Grant-E-G/muon_telescope/docs/datasheets/README.md

# Datasheet archive

This directory is the local design-document archive for selected parts and
existing equipment. Files were retrieved 2026-08-23 unless a later date is
stated, and are kept unmodified. The pulse-height documents were retrieved
2026-09-01.
Use the exact manufacturer number below: a family document does not make every
family member interchangeable. Recheck the linked primary source and revision
before a fabrication release because the local copy is intentionally a
snapshot.

When a part changes, update its BOM entry, local document, and this index in the
same change. Prefer manufacturer documents. Distributor pages are ordering
references, not substitutes for electrical or mechanical documentation.

## Semiconductors and power

| Selected manufacturer part(s) | Local document | Primary source |
|---|---|---|
| onsemi `MICROFC-60035-SMT-TR` | [C-Series datasheet](onsemi-microc-series.pdf); [bias/readout note AND9782/D](onsemi-and9782-sipm-bias-readout.pdf) | [onsemi datasheet](https://www.onsemi.com/pdf/datasheet/microc-series-d.pdf); [onsemi application note](https://www.onsemi.com/download/application-notes/pdf/and9782-d.pdf) |
| 3PEAK `TPH2502-SR` | [TPH2501-TPH2504 datasheet](3peak-tph2501-tph2504.pdf) | [3PEAK](https://static.3peak.com/res/doc/ds/Datasheet_TPH2501-TPH2502-TPH2503-TPH2504.pdf) |
| TI `TLV3502AIDR` | [TLV3501/TLV3502 datasheet](ti-tlv3501-tlv3502.pdf) | [TI](https://www.ti.com/lit/gpn/TLV3502) |
| TI `SN74LVC1G123DCTR` | [SN74LVC1G123 datasheet](ti-sn74lvc1g123.pdf) | [TI](https://www.ti.com/lit/ds/symlink/sn74lvc1g123.pdf) |
| Microchip `MCP3202-BI/SN` | [MCP3202 datasheet](microchip-mcp3202.pdf) | [Microchip](https://ww1.microchip.com/downloads/en/DeviceDoc/21034F.pdf) |
| Nexperia `BAS70,215` | [BAS70 datasheet](nexperia-bas70.pdf) | [Nexperia](https://assets.nexperia.com/documents/data-sheet/BAS70.pdf) |
| Nexperia `BSS138P,215` | [BSS138P datasheet](nexperia-bss138p.pdf) | [Nexperia](https://assets.nexperia.com/documents/data-sheet/BSS138P.pdf) |
| TI `TMUX1101DCKR` (precision reset alternate) | [TMUX1101/TMUX1102 datasheet](ti-tmux1101.pdf) | [TI](https://www.ti.com/lit/ds/symlink/tmux1101.pdf) |
| ADI/Maxim `MAX5026EUT+T` | [MAX5025-MAX5028 datasheet](adi-max5025-max5028.pdf) | [Analog Devices](https://www.analog.com/media/en/technical-documentation/data-sheets/max5025-max5028.pdf) |
| TI `TLV75533PDBVR` | [TLV755P datasheet](ti-tlv755p.pdf) | [TI](https://www.ti.com/lit/gpn/TLV755P) |
| onsemi `SS16HE` | [SS13HE-SS16HE datasheet](onsemi-ss13he-ss16he.pdf) | [onsemi](https://www.onsemi.com/pdf/datasheet/ss13he-d.pdf) |
| onsemi `SS14` | [SS12-SS110 datasheet](onsemi-ss12-ss110.pdf) | [onsemi](https://www.onsemi.com/pdf/datasheet/ss19-d.pdf) |
| Diodes Inc. `BAT54S-7-F` | [BAT54-series datasheet](diodes-bat54-series.pdf) | [Diodes Inc.](https://www.diodes.com/datasheet/download/BAT54S.pdf) |

## Passives

| Selected manufacturer part(s) | Local document | Primary source |
|---|---|---|
| Bourns `SRN6045-470M` | [SRN6045 datasheet](bourns-srn6045.pdf) | [Bourns](https://www.bourns.com/docs/product-datasheets/srn6045.pdf) |
| Littelfuse `1206L050YR` | [1206L datasheet](littelfuse-1206l.pdf) | [Littelfuse](https://www.littelfuse.com/assetdocs/littelfuse-ptc-1206l-datasheet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) |
| Bourns `3296W-1-501LF`, `3296W-1-103LF` | [3296 trimmer datasheet](bourns-3296.pdf) | [Bourns](https://www.bourns.com/pdfs/3296.pdf) |
| Panasonic `ERA-6AEB1473V`, `ERA-6AEB6981V` | [ERA-A resistor datasheet](panasonic-era-a-resistors.pdf) | [Panasonic](https://industrial.panasonic.com/cdbs/www-data/pdf/RDM0000/AOA0000C307.pdf) |
| Yageo `RC0805JR-070RL`, `RC0805FR-0710RL`, `RC0805FR-0722RL`, `RC0805FR-0749R9L`, `RC0805FR-0756RL`, `RC0805FR-0782RL`, `RC0805FR-07100RL`, `RC0805FR-07220RL`, `RC0805FR-07499RL`, `RC0805FR-071KL`, `RC0805FR-071K65L`, `RC0805FR-072KL`, `RC0805FR-074K7L`, `RC0805FR-0710KL`, `RC0805FR-0712K4L`, `RC0805FR-07100KL`, `RC0805FR-07130KL`, `RC0805FR-07330KL`, `RC0805FR-071ML` | [RC_L resistor datasheet](yageo-rc-l-resistors.pdf) | [Yageo](https://yageogroup.com/content/datasheet/asset/file/PYU-RC_GROUP_51_ROHS_L) |
| KEMET `C0805C104K5RACTU`, `C0805C105K4RACTU`, `C0805C475K4RACTU`, `C1206C106K8RACTU`, `C1206C105K5RACTU` | [X7R MLCC datasheet](kemet-x7r-mlcc.pdf) | [Yageo/KEMET](https://yageogroup.com/content/datasheet/asset/file/KEM_C1002_X7R_SMD) |
| KEMET `C0805C103J1GACTU`, `C0805C270J5GACTU`, `C0805C101J5GACTU`, `C0805C221J5GACTU`, `C0805C471J5GACTU`, `C0805C102J5GACTU`, `C0805C229C5GACTU` | [C0G MLCC datasheet](kemet-c0g-mlcc.pdf) | [Yageo/KEMET](https://yageogroup.com/content/datasheet/asset/file/KEM_C1003_C0G_SMD) |

## Connectors, cables, and external power

| Selected manufacturer part(s) | Local document | Primary source |
|---|---|---|
| JST `B10B-XH-A(LF)(SN)`, `XHP-10` | [XH connector datasheet](jst-xh-connectors.pdf) | [JST](https://www.jst-mfg.com/product/pdf/eng/eXH.pdf) |
| JST `ASXHSXH22K305` | [assembly drawing](jst-asxhsxh22k305-drawing.pdf) | [assembly drawing](https://gam-gec.com/wp-content/uploads/2018/10/GAM-198.pdf); [JST ordering page](https://www.digikey.com/en/products/detail/jst-sales-america-inc/ASXHSXH22K305/6684932) |
| Same Sky `PJ-102AH` | [connector datasheet](same-sky-pj-102ah.pdf) | [Same Sky](https://www.cuidevices.com/product/resource/pj-102ah.pdf) |
| Phihong `PSAC05A-050L6-R` | [PSAC05A datasheet](phihong-psac05a.pdf) | [Phihong](https://www.phihong.com/wp-content/uploads/PSAC05A.pdf) |
| Samtec `TSW-106-08-G-D-RA`, `TSW-120-07-G-S` | [TSW drawing](samtec-tsw-header-drawing.pdf) | [Samtec](https://suddendocs.samtec.com/prints/tsw-xxx-xx-xxx-x-xx-xxx-mkt.pdf) |
| Samtec `SNT-100-BK-G` | [SNT drawing](samtec-snt-shunt-drawing.pdf) | [Samtec](https://suddendocs.samtec.com/prints/snt-100-xx-x-x-mkt.pdf) |
| Digilent `240-109` | [Pmod interface specification](digilent-pmod-interface-specification-1.3.0.pdf) | [Digilent cable page](https://digilent.com/shop/2x6-pin-pmod-cable/); [Digilent specification](https://digilent.com/reference/_media/reference/pmod/pmod-interface-specification-1_3_0.pdf) |

Digilent does not publish a separate cable drawing for `240-109`; its product
page and the archived Pmod interface specification are the available primary
documentation. Continuity and mating orientation therefore remain an incoming
inspection requirement.

## Optical parts and existing equipment

| Selected item | Local document | Primary source |
|---|---|---|
| Bicron/Luxium BC-408; purchased seller-cut model `BC408-505010-1FP`, 50 x 50 x 10 mm, one face polished | [BC-400/404/408/412/416 datasheet](luxium-bc400-bc416.pdf) | [Luxium](https://luxiumsolutions.com/files/1691/download); [purchased cut-geometry listing](https://www.ebay.com/itm/254751779655) (no manufacturer drawing exists for the seller-cut geometry) |
| Eljen `EJ-550` optical coupling compound | [EJ-550/EJ-552 datasheet](eljen-ej550-ej552.pdf) | [Eljen](https://eljentechnology.com/images/products/data_sheets/EJ-550_EJ-552.pdf) |
| Digilent Cora Z7-07S | [schematic](digilent-cora-z7-schematic.pdf); [07S master XDC](digilent-cora-z7-07s-master.xdc); [Pmod interface specification](digilent-pmod-interface-specification-1.3.0.pdf) | [Digilent reference manual](https://digilent.com/reference/programmable-logic/cora-z7/reference-manual); [Digilent XDC repository](https://github.com/Digilent/digilent-xdc/blob/master/Cora-Z7-07S-Master.xdc); [Digilent product page](https://digilent.com/shop/cora-z7-zynq-7000-single-core-for-arm-fpga-soc-development/) |

The Cora reference manual is a maintained web document rather than a published
downloadable file. The release-critical schematic, XDC, and interface
specification are archived here; the current manual remains linked above.

## Independent home PCB fabrication process

These documents support the standalone workflow in
`docs/home-pcb-fabrication/`; they are not telescope design-part selections.
Files in the `home-pcb-fabrication/` subdirectory were retrieved from
2026-08-25 through 2026-08-28 and are unmodified.

| Selected manufacturer item | Local document | Primary source |
|---|---|---|
| MG Chemicals `415-1L` ferric chloride | [US/Canada SDS](home-pcb-fabrication/mg-415-ferric-chloride-sds-us-ca.pdf); [TDS](home-pcb-fabrication/mg-415-ferric-chloride-tds.pdf) | [SDS](https://www.mgchemicals.com/downloads/msds/01%20English%20Can-USA%20SDS/sds-415-l.pdf); [TDS](https://mgchemicals.com/downloads/tds/tds-415-l.pdf); [product](https://mgchemicals.com/products/circuit-board-design/copper-etchants/ferric-chloride-etching/) |
| MG Chemicals `540` double-sided copper clad | [500-series TDS](home-pcb-fabrication/mg-500-series-copper-clad-tds.pdf) | [TDS](https://www.mgchemicals.com/downloads/tds/tds-500-series.pdf); [ordering page](https://www.digikey.com/en/products/detail/mg-chemicals/540/2177370) |
| Existing Brother `HL-L2370DW` monochrome laser printer | [online user's guide](home-pcb-fabrication/brother-hl-l2370dw-online-user-guide.pdf) | [specifications](https://support.brother.com/g/b/spec.aspx?c=us_ot&lang=en&prod=hll2370dw_us); [manuals](https://support.brother.com/g/b/manualtop.aspx?c=us&lang=en&prod=hll2370dw_us) |
| Existing WEN `4208T` drill press | [4208/4208T manual](home-pcb-fabrication/wen-4208t-manual.pdf) | [product](https://wenproducts.com/products/wen-4208t-2-3-amp-8-inch-5-speed-benchtop-drill-press); [manual source](https://cdn.shopify.com/s/files/1/0012/0350/3168/files/4208T.manual.20220914.pdf?v=1664398265) |
| Genmitsu `PD30A` (`101-61S-PD30A`) tungsten-carbide PCB drill set | [PCB drill-bit buying guide](home-pcb-fabrication/genmitsu-pcb-drill-bits-buying-guide.pdf) | [product](https://www.sainsmart.com/products/genmitsu-30pcs-pcb-drill-bits-set-0-1mm-3-0mm-1-8-shank-pd30a); [buying guide](https://genmitsu.s3.us-east-1.amazonaws.com/Milling%20Bit%20Data%20Base/Genmitsu_CNC_Router_Bits_Buying_Guide_20230930.pdf) |
| Litoexpe `GAOC1570` 1.5 mm self-backing eyelets, Amazon ASIN `B0DYY6MCZS` | No stable static manufacturer drawing or manual identified; exact dimensions and materials are catalog claims and require incoming inspection | [maintained Amazon listing](https://www.amazon.com/dp/B0DYY6MCZS) |
| Litoexpe 1.5 mm eyelet tool set, seller SKU `GAOC1573`, Amazon ASIN `B0DYY4NCQW` | No manufacturer MPN or stable static drawing/manual is published; the seller SKU is retained only as the exact Amazon offer identity. Listing images publish an 8 x 98 mm forming ram and 22 x 18.2 mm base | [maintained Amazon listing](https://www.amazon.com/dp/B0DYY4NCQW) |
| StewMac `5975` brass pickup mini eyelets and `5976` Eyelet Setting Tool and Bit | No stable static manufacturer drawing or manual identified; use the maintained product and instruction pages | [eyelets](https://www.stewmac.com/electronics/pickups/pickup-parts/pickup-parts-for-strat/brass-pickup-eyelets-package-of-50/); [steel setting tool and 1.85 mm bit](https://www.stewmac.com/luthier-tools-and-supplies/tools-by-job/tools-for-electronics/pickup-building/eyelet-setting-tool-and-bit/); [instructions](https://www.stewmac.com/video-and-ideas/online-resources/learn-about-guitar-pickups-and-electronics-and-wiring/eyelet-setting-tool-and-bit-instructions/) |
| 3M `91252H1-DC-10` chemical-splash goggles | No stable static manufacturer specification identified; use the maintained product page | [3M `91252` product](https://www.3m.com/3M/en_US/p/d/b5005625014/) |
| Pyramex `G205` chemical splash goggles | [product sheet](home-pcb-fabrication/pyramex-g205-product-sheet.pdf) | [product](https://www.pyramex.com/products/chemical-splash-goggle-d3); [product sheet](https://www.pyramex.com/cdn/shop/files/G205_Series_ANSI_HiRes_46cc9b24-3b11-4b06-b8bc-a10efec43877.pdf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) |
| SHOWA `730-[size]` reusable nitrile gloves | [2026 retail catalog](home-pcb-fabrication/showa-2026-retail-catalog.pdf) | [product](https://www.showagroup.com/us-en/shop/730/); [catalog](https://www.showagroup.com/wp-content/uploads/2024/02/SHOWA-RetailCatalog_EN-2026-NEW-REV-DIGITAL-1.pdf) |
| First Aid Only `24-202-001` single 32 oz eye-flush station | [product sheet](home-pcb-fabrication/first-aid-only-eyewash-product-sheet.pdf) | [product sheet](https://externalassets.unilogcorp.com/ASSETS/DOCUMENTS/ITEMS/EN/First_Aid_Only_24-308_User_Manual.pdf); [single-unit clearance source](https://blackboxsafety.com/products/first-aid-only-eyewash-station-24-202-001) |
| PP/HDPE material-compatibility basis | [Thermo Scientific chemical-resistance guide](home-pcb-fabrication/thermo-plastics-chemical-resistance-guide.pdf) | [guide](https://assets.thermofisher.com/TFS-Assets/LCD/posters/LCD-Chemical-Resistance-Guide-GALSPCHEMRESPOSTER-EN.pdf) |
| NOAA HAZMAT Report 93-3 HCl partial-pressure and evaporation model | [report](home-pcb-fabrication/noaa-hazmat-93-3-hcl-properties.pdf) | [NOAA](https://library.oarcloud.noaa.gov/noaa_documents.lib/NOS/HMRA/HAZMAT_report_93-3.pdf) |

The following maintained pages were checked from 2026-08-28 through
2026-08-29. No separate stable static public drawing or manual was identified
for these budget items: NEIKO
adjustable automatic center punch `02638A`
([manufacturer](https://neikotools.com/products/neiko-02638a-5-automatic-center-hole-punch-adjustable-impact-spring-loaded-puncher-tool));
Paterson `PTP332` set of three 5 x 7 in developing trays, comprising the
`PTP322G`, `PTP322R`, and `PTP322W` tray variants
([manufacturer](https://www.patersonphotographic.ca/product/developing-tray/));
Rubbermaid Commercial `FG350900WHT` 3.5 gal HDPE food/tote box
([manufacturer](https://www.rubbermaidcommercial.com/foodservice/food-storage/foodtote-boxes-polyethylene/?sku=FG350900WHT));
PITTSBURGH PRO automatic center punch SKU `621`
([manufacturer/retailer](https://www.harborfreight.com/spring-loaded-center-punch-621.html));
U.S. Plastic item `97365`, 32 oz HDPE bottle with PP cap
([product](https://www.usplastic.com/catalog/item.aspx?itemid=165118)).

The IKEA SAMLA PP working box `701.029.72`, lid `504.550.88`, and secondary
box `401.029.78` remain recorded as superseded sourcing candidates
([working box](https://www.ikea.com/us/en/p/samla-box-clear-70102972/),
[lid](https://www.ikea.com/us/en/p/samla-lid-for-box-1-gallon-clear-50455088/),
[secondary box](https://www.ikea.com/us/en/p/samla-box-clear-40102978/)). They
are no longer selected because their geometry is inferior to the shallow
Paterson working tray and wide Rubbermaid secondary tote above.

Harfington `f25070700ux0179` 1.0 mm carbide PCB drills remain recorded as a
superseded shipped candidate ([product](https://www.harfington.com/products/p-1889293)).
They are no longer selected because their Amazon entry was only a search page;
the BOM now selects the documented Genmitsu `PD30A` direct Amazon ASIN.

The Nalgene 32 oz HDPE wide-mouth consumer bottle, Amazon ASIN `B000KA6AOU`,
is recorded only as a conditional waste-bottle candidate
([Amazon](https://www.amazon.com/dp/B000KA6AOU),
[manufacturer family page](https://nalgene.com/product/32oz-wide-mouth-ultralite-bottle/)).
Amazon does not expose a stable Nalgene laboratory MPN for that offer, so it
is not a selected replacement for U.S. Plastic item `97365`.

The generic copper clad and transfer paper have no manufacturer
drawing or reliable static technical document. Their purchase references are
GeeBat `GB0021`, Amazon ASIN `B01MRG7NHC`
([listing](https://www.amazon.com/dp/B01MRG7NHC)); Ximimark
`XQJ=LY251-XQJ-FBA`, Amazon ASIN `B07MYXK4WJ`
([listing](https://www.amazon.com/dp/B07MYXK4WJ)). Treat these listings as
purchase references only; incoming measurement and the process coupon are the
technical acceptance record. Generic `M0.9(d) x 2.5(L) mm` hollow PCB rivets,
Amazon ASIN `B015CV377O` ([listing](https://www.amazon.com/dp/B015CV377O)), are
retained only as a superseded candidate. The selected Amazon trial pair is
Litoexpe `GAOC1570` eyelets, ASIN `B0DYY6MCZS`, and the matching 1.5 mm tool
set, seller SKU `GAOC1573`, ASIN `B0DYY4NCQW`. The eyelet listing publishes
2.0 mm barrel OD, 3.5 mm flange OD, and 3.45 mm overall height, but also
ambiguously describes an iron “gasket”; the BOM therefore requires incoming
measurement, magnet inspection, solder-wetting, and continuity qualification.
StewMac `5975`/`5976` remains only a higher-cost process comparison.

QWORK/Co-link model `JJ07-18`, part `SHK-011`, Amazon ASIN `B00QWE5PR6`
([Amazon](https://www.amazon.com/dp/B00QWE5PR6)), is a rejected leathercraft
candidate. No stable manufacturer manual was identified. Its two hollow
punches are 2.5 and 3.0 mm, while its lower support positions are 6, 7, 8, 9,
10, 12, and 15 mm. It does not include a PCB-scale eyelet roll-forming die.
