Grant-E-G/muon_telescope/docs/home-pcb-fabrication/bom.md

# Cost-optimized home PCB fabrication BOM

This is a standalone BOM for the workflow in this folder, not part of the
telescope electronics BOM. Prices and links were checked 2026-08-29. Amazon
prices, sellers, quantities, and fulfillment are volatile, so the tables give
a **delivered buy ceiling** (item plus mandatory shipping, before sales tax):
skip a listing above that price or when the seller does not identify the
required item precisely.

The objective is a useful stock of consumables, not one board at industrial
lab prices. Generic items require incoming inspection and a process coupon.
Compare **delivered** cost, not the item price. A dedicated one-hour pickup trip
is not free: prefer an Amazon or other shipped option below its recorded ceiling
and use a local source when it can be combined with another trip.

An Amazon listing is only a source option. It does not permit a different
chemical, plastic, PPE model, glove size, or tool. Record the seller and
delivered price at checkout, then verify the received manufacturer identity,
quantity, material, size, lot, and expiration date when applicable.

## Amazon convenience-sourcing record

This table supplements the cost-optimized line-item tables below. A row counts
as an Amazon option only when it has a direct ASIN link to the qualified item.
A search-results page is not a purchase option. “Reuse” is deliberately the
$0 option.

| Function | Amazon option | Reference price / ceiling | Checkout and receipt requirement |
|---|---|---:|---|
| Copper-clad stock | [GeeBat GB0021, ASIN B01MRG7NHC](https://www.amazon.com/dp/B01MRG7NHC) | target $14; **$18 delivered ceiling** | Verify ten nominal 70 x 100 x 1.5 mm double-sided copper-clad FR-4 blanks. |
| Toner-transfer paper | [Ximimark XQJ=LY251-XQJ-FBA, ASIN B07MYXK4WJ](https://www.amazon.com/dp/B07MYXK4WJ) | target $9; **$12 delivered ceiling** | Verify 20 A4 sheets intended for laser-toner PCB transfer. |
| Ferric-chloride etchant | [MG Chemicals 415-1L, ASIN B005T8Y20W](https://www.amazon.com/dp/B005T8Y20W) | user-observed $21 on 2026-08-27; **$25 delivered ceiling** | Preferred over a dedicated one-hour drive. Verify sealed MG `415-1L`, nominal 1 L package (945 mL net contents), with no leak or crystallized closure. |
| Shallow PP working bath and loose cover | **No qualified Amazon listing found.** Buy Paterson `PTP332` directly from [B&H](https://www.bhphotovideo.com/c/product/40358-REG/Paterson_PTP332_Plastic_Developing_Tray_Set.html); [manufacturer](https://www.patersonphotographic.ca/product/developing-tray/) | B&H listed $17.95; **$25 delivered ceiling** | This replaces the tall food-storage tubs. The nominal 127 x 178 mm processing area easily fits a 70 x 100 mm panel, and the ribbed base is intended to minimize solution volume. Use one tray as the bath and rest a second tray upside-down over it as a loose, visibly vented splash cover; never seal or latch them. Before etchant, verify with 100 mL water that the panel remains covered during a gentle tilt. |
| HDPE secondary containment | Rubbermaid Commercial `FG350900WHT`, 3.5 gal, 18 x 12 x 6 in: [Amazon ASIN B000VAUFT0](https://www.amazon.com/Rubbermaid-Commercial-Storage-Gallon-White/dp/B000VAUFT0), [manufacturer](https://www.rubbermaidcommercial.com/foodservice/food-storage/foodtote-boxes-polyethylene/?sku=FG350900WHT) | target $25; **$32 delivered ceiling** | Selected replacement for the narrow/tall Cambro search. Rubbermaid identifies the exact tote as HDPE with 13.25 L capacity. No lid is needed for secondary containment. Dry-fit the working tray, rinse containers, and every liquid staged for the run, then verify that a complete working-bath spill stays below the rim. Do not accept Amazon's clear polycarbonate variants. |
| Board-handling tongs | **No qualified Amazon listing found; reuse a verified one-piece PP tool.** | $0 | Amazon's inexpensive listings generally omit the exact resin. Accept only a one-piece tool molded `PP`/resin-code-5, without a metal spring, fastener, insert, or hollow liquid-trapping handle. |
| Rinse containers | Reuse two verified HDPE or PP containers | $0 | Label for PCB work and never return to food use. |
| Spent-etchant bottle | Reuse first; conditional [Nalgene 32 oz HDPE wide-mouth bottle, ASIN B000KA6AOU](https://www.amazon.com/dp/B000KA6AOU) | Amazon listed $11.99; **$16 delivered ceiling** if a new bottle is necessary | This direct listing identifies a 32 oz HDPE, leakproof bottle but not a stable Nalgene laboratory MPN, so it remains a conditional consumer-bottle candidate. Require a molded HDPE body, compatible nonmetal cap, leak test, at least 1 L nominal capacity, and local HHW acceptance before use. Never pour spent etchant down a drain. |
| Splash goggles | [3M `91252H1-DC-10`, ASIN B00467C7AE](https://www.amazon.com/dp/B00467C7AE); [manufacturer](https://www.3m.com/3M/en_US/p/d/b5005625014/) | Amazon recently listed $4.49; **$8 delivered ceiling** | Verify exact 3M `91252` chemical-splash goggles, indirect ventilation, ANSI Z87.1 marking, and intact lens and strap. Do not substitute open safety glasses. |
| Chemical gloves | [SHOWA `730-09.RT`, size 9/L, ASIN B07GL6V229](https://www.amazon.com/dp/B07GL6V229); [manufacturer](https://www.showagroup.com/us-en/shop/730/) | recently $6.55; **$8 delivered ceiling** | The direct link is for size 9/L. Select a different size on the same listing only if the exact `730-[size].RT` identity remains visible. Verify 13 in nominal length, 15 mil nominal thickness, and an intact pair. |
| Immediate eye flush | [First Aid Only / PhysiciansCare 24-202, ASIN B002A6AFDY](https://www.amazon.com/dp/B002A6AFDY) | target $20; **$22 delivered ceiling** | Verify the received station and bottle identity against the archived `24-202-001` product sheet, 32 fl oz fill, intact seal, and usable expiration. Reject an obscured model, reduced volume, damaged seal, or short-dated bottle. |
| Carbide PCB drill bits | Existing Genmitsu `PD30A`: [manufacturer](https://www.sainsmart.com/products/genmitsu-30pcs-pcb-drill-bits-set-0-1mm-3-0mm-1-8-shank-pd30a), [Amazon reference ASIN B08M5PLF48](https://www.amazon.com/dp/B08M5PLF48) | **Already owned; $0** | Verify one each from 0.1 through 3.0 mm, 3.175 mm shanks, and intact 2.0 and 2.1 mm tips. Trial both sizes with the 2.0 mm nominal eyelet barrel; do not force an eyelet into an undersize drilled hole. |
| Printed drill hood | Print from repository source | about $1 material | No Amazon purchase. Record filament and the successful vacuum-capture test in the build log. |
| Vacuum and filter/bag | Existing vacuum only | $0 | Verify the current filter/bag is fitted and serviceable. Do not buy an unqualified substitute from a recommendation carousel. |
| Through-hole eyelets and setting tooling | **Selected Amazon trial pair:** Litoexpe 1.5 mm die set, seller SKU `GAOC1573`, [ASIN B0DYY4NCQW](https://www.amazon.com/dp/B0DYY4NCQW), plus Litoexpe 200-piece gold eyelets, item model `GAOC1570`, [ASIN B0DYY6MCZS](https://www.amazon.com/dp/B0DYY6MCZS) | $5.99 + $4.49 = **$10.48 with Prime/$35 cart; $17.47 if Amazon charges one $6.99 non-Prime shipment; $18 delivered ceiling** | Both pages were Amazon-fulfilled and Prime-eligible when checked. The tool listing publishes a straight 8 x 98 mm steel upper ram, which is within the WEN's 0.5 in / 12.7 mm chuck capacity, and a 22 x 18.2 mm matched base. Eyelets publish 2.0 mm barrel OD, 3.5 mm flange OD, and 3.45 mm overall height. The listing describes brass eyelets and an iron “gasket”; magnet-test and solder/continuity-qualify a coupon before any board layout. |

### Superseded container sourcing record

These links are retained to prevent the rejected tall/narrow choices from
quietly returning in a later search. They are **not approved substitutes** for
the selected Paterson tray and Rubbermaid tote.

| Function | Rejected option | Reason rejected |
|---|---|---|
| Working bath | Cambro 4 qt round two-pack `4RPP2PKB190`, [ASIN B0CZ552H67](https://www.amazon.com/dp/B0CZ552H67); square Cambro `4SFSPP190` with `SFC2-452` lid, [lid ASIN B07SPVM8ZZ](https://www.amazon.com/dp/B07SPVM8ZZ) | Food-storage geometry is much taller than necessary and does not provide the wide, shallow liquid footprint wanted for a 70 x 100 mm panel. The bundle also did not document every resin and exact component identity well enough at checkout. |
| Secondary containment | Cambro `12SFSPP190` | Too tall and too narrow for convenient staging. Amazon also mixes in the clear polycarbonate `12SFSCW135`, which is a different material and MPN. |
| Working bath and secondary containment | IKEA SAMLA `701.029.72` with lid `504.550.88`, and SAMLA `401.029.78` secondary box: [working box](https://www.ikea.com/us/en/p/samla-box-clear-70102972/), [lid](https://www.ikea.com/us/en/p/samla-lid-for-box-1-gallon-clear-50455088/), [secondary box](https://www.ikea.com/us/en/p/samla-box-clear-40102978/) | Previously selected only as low-cost local PP containers. Their geometry is inferior to the shallow Paterson tray and wide Rubbermaid tote, and a dedicated pickup trip defeats the convenience objective. |

The eye-flush entry is a qualified sourcing alternative; record the accepted
received identity below. The consumer Nalgene bottle remains only a conditional
candidate because the Amazon catalog does not expose a stable manufacturer
laboratory MPN.

### Eyelet-tooling design record

The selected Amazon trial system is Litoexpe seller SKU `GAOC1573`, ASIN
`B0DYY4NCQW`: a 1.5 mm stainless-steel eyelet tool set containing a straight
8 x 98 mm upper forming ram, 22 x 18.2 mm matching lower base, and separate
hollow punch. The straight 8 mm ram shown by the exact listing is the part to
grip in the stationary WEN
`4208T` chuck; it is below the manual's 0.5 in / 12.7 mm chuck capacity. The
hollow punch is not used on FR-4. The WEN supplies the guided hand-operated ram
and depth stop while switched off and unplugged. Clamp the matching lower base
so it cannot translate or tilt.

The matched consumable is Litoexpe item model `GAOC1570`, ASIN `B0DYY6MCZS`,
200 self-backing gold eyelets. The exact listing image publishes a 2.0 mm
barrel OD, 3.5 mm flange OD, and 3.45 mm overall height. “1.5 mm” describes the
nominal opening, not the PCB drill diameter. This remains a **coupon-qualified
selection**, not permission to freeze a board footprint: measure at least five
received parts and trial the owned 2.0 and 2.1 mm Genmitsu drills in actual
nominal 1.5 mm stock. Prefer the larger, sturdier 2.1 mm drill only if it does
not leave excessive eyelet wobble. No selected hole may exceed 3.0 mm.

The eyelet listing describes the eyelet as brass and an associated “gasket” as
iron, while its photographs show a self-backing one-piece form. That material
description is too ambiguous for an electrical via. Check the received part
with a magnet, expose/inspect both formed faces, and require normal solder
wetting and stable continuity on the coupon. Reject the system if iron is in
the current path, plating flakes, corrosion appears, or solder will not wet.

The selected arrangement must meet all of these requirements before a real
board is committed:

| Requirement | Acceptance check |
|---|---|
| Reach | At least 35 mm clear throat reaches every point on a 70 mm-wide board. |
| Motion | Gradual hand force, no impact event, little lateral jaw motion, and a controllable stop or readily repeated endpoint. |
| Lower tool | Exact Litoexpe lower base supports the factory flange and nearby board without rocking, denting the copper, or bowing the laminate; clamp it to the table. |
| Upper tool | Exact Litoexpe `GAOC1573` straight steel ram is held securely in the stationary WEN chuck and rolls the matched eyelet tail. |
| Tool retention | Ram shank is securely gripped by the chuck with the chuck key removed; lower base is clamped to the table and cannot slide or tilt. |
| Access and safety | The panel lies flat, both collars remain inspectable, and fingers stay outside the closing jaws. |
| Coupon result | Even retaining flare; no split tail, lifted pad, cracked laminate, loose eyelet, tilt, or board deformation; both collars are then soldered and continuity-tested. |

The QWORK/Co-link 11-piece kit, model `JJ07-18` / ASIN `B00QWE5PR6`, is also
rejected despite its attractive $8 observed Amazon price. Its 2.5 and 3.0 mm
pieces are hollow punches. Its universal lower base has 6, 7, 8, 9, 10, 12,
and 15 mm support positions for leather snaps and cap rivets; none is a
roughly 1.5-2.0 mm eyelet rolling profile. It would not controllably form the
PCB-scale hollow barrel.

The separate hand-rivet gun, leather-rivet kit, automatic punch, Voltera spike,
and imported PCB press/tooling families remain rejected for this build. They
either lack matching micro-eyelet tooling, duplicate the WEN's frame and
leverage, or cost substantially more. The owned center punch is the $0 fallback
if the Litoexpe ram does not grip securely or its profile proves wrong, but it
lacks a matched forming nose and lower base. The WEN manual does not specify an
eyelet-press rating: use small increments, set the depth stop on scrap, and stop
if appreciable spindle load or board deformation is required.

## Already owned: buy nothing

| Function | Existing item | Added cost | Use |
|---|---|---:|---|
| Printer | Brother `HL-L2370DW`: [specifications](https://support.brother.com/g/b/spec.aspx?c=us_ot&lang=en&prod=hll2370dw_us), [local guide](../datasheets/home-pcb-fabrication/brother-hl-l2370dw-online-user-guide.pdf) | $0 | Use the installed toner and the manual feed/rear face-up path. The coupon qualifies the toner and transfer paper together. |
| Transfer heat | Existing workshop iron or laminator | $0 | No new press or laminator. |
| Drill | WEN `4208T` and vise: [manufacturer](https://wenproducts.com/products/wen-4208t-2-3-amp-8-inch-5-speed-benchtop-drill-press), [local manual](../datasheets/home-pcb-fabrication/wen-4208t-manual.pdf) | $0 | Highest speed, full backer support, light feed, and a coupon first. |
| PCB drills | Existing Genmitsu `PD30A`, 0.1-3.0 mm by 0.1 mm increments: [manufacturer](https://www.sainsmart.com/products/genmitsu-30pcs-pcb-drill-bits-set-0-1mm-3-0mm-1-8-shank-pd30a), [local guide](../datasheets/home-pcb-fabrication/genmitsu-pcb-drill-bits-buying-guide.pdf) | $0 | Inspect the 2.0 and 2.1 mm tools for the selected eyelet coupon. |
| Dust collection | Existing shop vac, serviceable dry cartridge/filter, and collection bag if already available | $0 | Use outdoors with a close-capture hood and direct exhaust away from people. Do not buy a new extractor. |
| Assembly and inspection | Existing assembly equipment, multimeter, magnification, ordinary hand tools, and center punch fallback | $0 | No assembly or soldering supplies are part of this BOM. |

## Consumables and containers

| Function | Cost-optimized selection | Qty. | Target / buy ceiling | Notes |
|---|---|---:|---:|---|
| Copper clad | GeeBat `GB0021`, Amazon ASIN `B01MRG7NHC`, ten nominal 70 x 100 x 1.5 mm double-sided FR-4 blanks: [Amazon](https://www.amazon.com/dp/B01MRG7NHC) | 1 pack | target $14, **do not exceed $18** | Much lower unit cost than individual branded blanks. Copper weight is not documented; inspect flatness, thickness, copper adhesion, and etch time on the coupon. Maximum board size becomes 70 x 100 mm. If a larger board is actually needed, buy one MG Chemicals `540` 3 x 5 in blank instead of both options. |
| Toner-transfer paper | Ximimark `XQJ=LY251-XQJ-FBA`, 20 A4 PCB-transfer sheets, Amazon ASIN `B07MYXK4WJ`: [Amazon](https://www.amazon.com/dp/B07MYXK4WJ) | 1 pack | target $9, **do not exceed $12** | This replaces the branded five-sheet pack. Later Brother printer/toner combinations are variable, so do not buy a second pack until the artwork coupon transfers cleanly. |
| Etchant | MG Chemicals `415-1L` ready-to-use ferric chloride: [manufacturer](https://mgchemicals.com/products/circuit-board-design/copper-etchants/ferric-chloride-etching/), [Amazon ASIN B005T8Y20W](https://www.amazon.com/dp/B005T8Y20W), [Anchor Electronics](https://anchor-electronics.com/product/mgchemicals-415-ferric-chloride/) | 1 | Amazon observed $21; **do not exceed $25 delivered** | The $21 Amazon option is preferred to a dedicated one-hour pickup drive. Use the $18.01 Anchor option only on a combined trip. Use at most 100 mL in the working tray and reuse it while it still etches acceptably; keep fresh and used material separately labeled. |
| Working bath and loose cover | Paterson `PTP332`, three 5 x 7 in chemical-resistant polypropylene developing trays: [manufacturer](https://www.patersonphotographic.ca/product/developing-tray/), [B&H](https://www.bhphotovideo.com/c/product/40358-REG/Paterson_PTP332_Plastic_Developing_Tray_Set.html) | 1 set | target $17.95; **do not exceed $25 delivered** | No qualified Amazon listing was found. Use one tray for etchant and invert a second loosely over it as the vented splash cover. The third is a labeled spare, not permission to mix chemical and food use. The 5 x 7 in processing area is intentionally close to the panel size so no more than 100 mL can cover the board. Qualify actual coverage with water before opening etchant. |
| Secondary containment | Rubbermaid Commercial `FG350900WHT`, 3.5 gal, 18 x 12 x 6 in HDPE food/tote box: [manufacturer](https://www.rubbermaidcommercial.com/foodservice/food-storage/foodtote-boxes-polyethylene/?sku=FG350900WHT), [Amazon ASIN B000VAUFT0](https://www.amazon.com/Rubbermaid-Commercial-Storage-Gallon-White/dp/B000VAUFT0) | 1 | target $25; **do not exceed $32 delivered** | No lid is required. Its verified 13.25 L capacity and wide footprint replace the IKEA and Cambro candidates. Dry-fit all staged liquid containers and verify the spill margin before use. |
| Board handling | Reused one-piece PP serving tongs with a molded `PP`/resin-code-5 mark | 1 | $0 | No qualified exact online listing was found. Inspect for exposed metal, cracks, or a hollow section that can trap etchant. Dedicate it to chemical work. |
| Rinse containers | Two clean, reused #2 HDPE or #5 PP household containers with identifying labels | 2 | $0 | Permanently mark them chemical-use-only. Do not use glass or metal. |
| Waste bottle | 32 oz HDPE bottle with PP screw cap, U.S. Plastic item `97365`: [source](https://www.usplastic.com/catalog/item.aspx?itemid=165118), or a local equivalent | 1 | $1.89 before shipping; **buy locally if shipping dominates** | Confirm the container and size with the local HHW program. Deface it and label actual contents and date. A larger compatible bottle is needed if captured rinse volume will exceed 32 oz. |

## Minimum personal protection

| Function | Selected item/source | Qty. | Target cost | Notes |
|---|---|---:|---:|---|
| Splash goggles | 3M `91252H1-DC-10` chemical-splash goggles: [manufacturer](https://www.3m.com/3M/en_US/p/d/b5005625014/), [Amazon ASIN B00467C7AE](https://www.amazon.com/dp/B00467C7AE). Pyramex `G205` remains a documented shipped alternative: [manufacturer](https://www.pyramex.com/products/chemical-splash-goggle-d3), [single-unit source](https://hdsupplysolutions.com/p/pyramex-chemical-splash-goggles-clear-body-clear-lens-p414897) | 1 | Amazon target $4.49; **do not exceed $8 delivered** | The 3M model has indirect ventilation and meets ANSI Z87.1. If using the alternative, require exact Pyramex `G205` with D3 marking. Ordinary safety glasses are not a substitute. |
| Chemical gloves | SHOWA `730-[size].RT`, 13 in, 15 mil reusable nitrile: [manufacturer](https://www.showagroup.com/us-en/shop/730/), [Amazon size 9/L ASIN B07GL6V229](https://www.amazon.com/dp/B07GL6V229), [size 9 distributor reference](https://www.grainger.com/product/SHOWA-Chemical-Resistant-Gloves-4JF19) | 1 correctly sized pair | Amazon target $6.55; **do not exceed $8 delivered; do not buy a case** | The Amazon link is a direct size-9 listing, not a search. Choose the wearer's size and record the exact variant; do not buy size 9 merely because it is linked. Brief splash handling only. Rinse the exterior after a splash and replace damaged gloves. Never wear them at the drill press. |
| Immediate eye flush | First Aid Only `24-202-001`, single 32 oz eye-flush station: [product sheet](../datasheets/home-pcb-fabrication/first-aid-only-eyewash-product-sheet.pdf), [Amazon candidate ASIN B002A6AFDY](https://www.amazon.com/dp/B002A6AFDY), [clearance source](https://blackboxsafety.com/products/first-aid-only-eyewash-station-24-202-001) | 1 | target $20 on Amazon; **do not exceed $22 delivered** | Confirm exact model identity against the product sheet before accepting an Amazon listing; record the received model and expiration below. This is immediate first flush only; continue at the already-tested household sink/shower for the etchant SDS's 30 minutes. Replace after opening. |

Long sleeves, long pants, closed shoes, an unobstructed route to a household
sink/shower, ordinary wipes, and labels are existing household provisions.

## Drilling and dust capture

| Function | Cost-optimized selection | Qty. | Target / buy ceiling | Notes |
|---|---|---:|---:|---|
| PCB drill set | Existing Genmitsu `PD30A`, 30 tungsten-carbide spiral-flute PCB drills, one each from 0.1 through 3.0 mm, 3.175 mm shank, 38 mm overall: [manufacturer](https://www.sainsmart.com/products/genmitsu-30pcs-pcb-drill-bits-set-0-1mm-3-0mm-1-8-shank-pd30a), [local guide](../datasheets/home-pcb-fabrication/genmitsu-pcb-drill-bits-buying-guide.pdf), [Amazon reference ASIN B08M5PLF48](https://www.amazon.com/dp/B08M5PLF48) | 1 set, owned | $0 | These are actual spiral-flute PCB drills, not engraving burrs or end mills. Inspect the 2.0 and 2.1 mm tips. Trial both on a coupon for the selected 2.0 mm nominal barrel and retain the largest hole that has low insertion force without excessive wobble. |
| Close-capture hood | 3D-printed shop-vac nozzle/holder using existing filament and common hardware | 1 | about $1 incremental material | Rigidly mount it beside the bit and dry-run full quill travel. The print is a hood, not a filter. |
| Vacuum consumables | Existing compatible dry collection bag and serviceable cartridge/filter | 1 set | $0 if already fitted | For a few holes outdoors, do not buy a new HEPA vacuum. Replace only a missing or damaged model-specific filter/bag. |

## Budget eyelet system: selected Amazon trial pair

The existing WEN drill press is the hand-operated ram. No separate press or
hand riveter is required. The Litoexpe pair below is a direct, matched Amazon
option and remains conditional on receipt inspection and a formed/soldered
coupon.

| Function | Exact item/source | Qty. | Target / buy ceiling | Notes |
|---|---|---:|---:|---|
| Self-backing eyelets | Litoexpe `GAOC1570`, 200 pieces, gold, [Amazon ASIN B0DYY6MCZS](https://www.amazon.com/dp/B0DYY6MCZS) | 1 pack | observed $4.49 | Exact listing dimensions: 2.0 mm barrel OD, 3.5 mm flange OD, 3.45 mm overall height; nominal opening 1.5 mm. Listing says brass eyelet plus iron “gasket,” so magnet-test and qualify solder wetting/current path. |
| Upper forming ram, lower base, and unused hollow punch | Litoexpe seller SKU `GAOC1573`, 1.5 mm stainless-steel set, [Amazon ASIN B0DYY4NCQW](https://www.amazon.com/dp/B0DYY4NCQW) | 1 set | observed $5.99 | Listing says precision heat-treated stainless steel and publishes an 8 x 98 mm forming ram and 22 x 18.2 mm base. The 8 mm ram fits within the WEN's 12.7 mm chuck capacity. Chuck only that ram in the stationary, unplugged WEN; clamp the matched base. Do not use the separate hollow punch on FR-4. |
| Fallback upper tool | Existing center punch | 1, owned | $0 | Use only if its tip forms a clean, concentric coupon flare without splitting the tail; it has no matched profile and is inferior to the selected ram. |

The matched pair is **$10.48 before tax with Prime or as part of a qualifying
$35 Amazon cart**. Amazon displayed $6.99 shipping for non-Prime orders below
$35; if charged once for the pair, the delivered total is **$17.47 before
tax**. Do not buy the pair above the **$18 delivered ceiling**. StewMac
`5975`/`5976` remains a $37.68-before-shipping comparison, not the selection.

## Realistic total

The Amazon-first plan below uses the observed or target values, with the full
Amazon allowances for goggles and gloves. It includes the newly selected
Paterson working-tray set and Rubbermaid secondary tote, while reusing suitable
rinse containers, tongs, and a waste bottle.

| Group | Target subtotal |
|---|---:|
| Ten blanks, 20 transfer sheets, and MG `415-1L` from Amazon | $44 |
| Paterson `PTP332` working trays and Rubbermaid `FG350900WHT` secondary tote | $43 |
| Reused verified rinse containers, tongs, and waste bottle | $0 |
| Goggles, one reusable glove pair, and Amazon eyewash allowance | up to $36 |
| Owned Genmitsu `PD30A`; printed hood material | $1 |
| Litoexpe eyelets and matched steel setting tooling | $10.48 Prime/qualifying cart; $17.47 standalone non-Prime case |
| **Startup items with both new containers** | **about $134 with free Amazon delivery, or $141 with the recorded $6.99 eyelet-pair shipping, before sales tax** |

The target is about $134 delivered before sales tax when the eyelet pair ships
free, or $141 with one $6.99 non-Prime shipping charge. It is about $91/$98
when already-qualified working and secondary containers are reused. Record the
actual checkout total because Amazon account, cart, and address determine
shipping. The purchase leaves ten blanks, twenty
transfer sheets, and the owned 30 drill sizes; it is not a one-board cost.
After the reusable safety items
and tools are owned, the consumable cost of another small board is roughly **$4-8**,
depending mainly on failed transfers and etchant reuse.

## Purchase and receipt ledger

Change `not ordered` to `ordered`, then `received` and `accepted` or `rejected`.
Record the actual marketplace seller because it can change under an ASIN. Use
delivered cost including shipping and tax. Do not commit a delivery address,
payment details, or a full marketplace order number to this repository.

| Function | Planned identity | Qty. | Status | Order date / seller / delivered cost | Receipt identity, lot or expiration, and acceptance evidence |
|---|---|---:|---|---|---|
| Copper-clad stock | GeeBat `GB0021`, ASIN `B01MRG7NHC` | 1 pack | not ordered | — | Record measured count, panel dimensions/thickness, flatness, and coupon result. |
| Toner-transfer paper | Ximimark `XQJ=LY251-XQJ-FBA`, ASIN `B07MYXK4WJ` | 1 pack | not ordered | — | Record sheet count and Brother toner-transfer coupon result. |
| Ferric-chloride etchant | MG Chemicals `415-1L`, ASIN `B005T8Y20W` | 1 | not ordered | — | Record exact label identity, lot/date code, seal and bottle condition, and net-volume marking. |
| Working bath and loose cover | Paterson `PTP332` 5 x 7 in tray set | 1 set | not ordered | — | Record exact tray MPNs/material, condition, dedicated labels, 100 mL water-coverage test, inverted-cover vent gap, and fit inside the secondary tote. |
| Secondary containment | Rubbermaid Commercial `FG350900WHT`, Amazon ASIN `B000VAUFT0` | 1 | not ordered | — | Record exact MPN, molded HDPE mark, 18 x 12 x 6 in dimensions, condition, dry-fit of all staged liquids, and spill-margin check. |
| Board-handling tongs | Reused or one-piece PP | 1 | not ordered | — | Record material marking and inspection for metal, cracks, and trapped-volume features. |
| Rinse containers | Reused HDPE or PP | 2 | not ordered | — | Record resin marks, volume, closure, and chemical-use labels. |
| Spent-etchant bottle | Reused HDPE/compatible cap or separately qualified exact item | 1 | not ordered | — | Record body/cap materials, capacity, leak test, HHW acceptance, contents label, and first-use date. |
| Splash goggles | 3M `91252H1-DC-10`, Amazon ASIN `B00467C7AE`; or documented Pyramex `G205` alternative | 1 | not ordered | — | Record exact model/markings and lens, vent, and strap inspection. |
| Chemical gloves | SHOWA `730-[size]` | 1 pair | not ordered | — | Record exact model, selected size, package/lot code, and condition. |
| Immediate eye flush | First Aid Only `24-202-001`; Amazon ASIN `B002A6AFDY` only after identity check | 1 | not ordered | — | Record exact received MPN, 32 fl oz marking, lot, expiration, intact seal, and mount condition. |
| Carbide drills | Genmitsu `PD30A`, Amazon reference ASIN `B08M5PLF48` | 1 set | **owned; inspect** | existing | Record exact MPN, count and size sequence, shank/length check, 2.0/2.1 mm tip inspection, and drilled coupon diameter. |
| Printed hood | Repository design | 1 | not made | — | Record filament, print revision, mounting, quill-clearance check, and capture-test result. |
| Vacuum filter/bag | Existing model-compatible items | 1 set | inspect existing | — | Record vacuum model, filter/bag identity and condition, and exhaust-direction check. |
| Self-backing eyelets | Litoexpe `GAOC1570`, ASIN `B0DYY6MCZS` | 1 pack of 200 | not ordered | observed $4.49 on Amazon, 2026-08-29 | Record exact package identity, count, dimensions, magnet response/material construction, fit in 2.0/2.1 mm coupon holes, and formed/soldered continuity result. |
| Upper steel ram and lower base | Litoexpe seller SKU `GAOC1573`, ASIN `B0DYY4NCQW` | 1 set | not ordered | observed $5.99 on Amazon, 2026-08-29 | Record exact listing/package identity, component count, material/finish, measured confirmation of the listed 8 mm ram diameter and secure WEN chuck fit, base clamping, depth-stop setting, and coupon result. |
| Existing center punch fallback | Existing tool; exact identity unknown | 1 | **owned; fallback only** | existing | Record tip geometry and coupon result only if the selected ram fails receipt inspection. Do not use it merely to avoid qualifying the matched tool. |
| Rejected QWORK/Co-link craft kit | `JJ07-18`, ASIN `B00QWE5PR6` | 0 | **rejected** | user observed $8 on Amazon, 2026-08-29 | Two hole punches are 2.5/3.0 mm; base positions are 6-15 mm. No PCB-scale eyelet rolling die. Do not order for this function. |

## Explicitly not required

- no Dynalon or other laboratory secondary-containment tray;
- no separate PCB press, hand rivet gun, or leather-rivet kit; the unplugged
  WEN, Litoexpe upper ram, and matched lower base form the eyelets; the owned
  center punch remains a coupon-only fallback;
- no plumbed eyewash, face shield, specialty spill kit, chemical apron, or
  respirator for this small outdoor process;
- no new HEPA dust extractor; and
- no soldering or fume-extraction purchases.
