Grant-E-G/muon_telescope/(commit log)

2026-08-23 updated bom and design docs
2026-08-25 over the top safety for home pcb fab
2026-08-27 updated pcb fabrication at home
2026-08-28 accepting amazon upgrade for bom
2026-08-29 updated pcb home build
2026-08-29 accepting bom
2026-08-29 updated last prekicadwork and fixed kicad verison to 9.0.9
    [power_interface.kicad_pcb, power_interface.kicad_sch]
2026-08-29 added power board
2026-09-01 feat: added schemas for muon detector head
    [muon_detector_head.kicad_pcb, muon_detector_head.kicad_sch]
2026-09-05 feat: added footprints and custom symbols and stuff
    [muon_detector_head.kicad_sch]
2026-09-05 new footprint started
